jacobbartzen/Alexa_Door_Control/credentials.h

#pragma once

#define WIFI_SSID       "WIFI_SSID"
#define WIFI_PASS       "WIFI_PASS"

#define SINRIC_APP_KEY      "GLOBAL_APP_KEY"       // From Sinric Pro dashboard
#define SINRIC_APP_SECRET   "GLOBAL_APP_SECRET"    // From Sinric Pro dashboard
#define SINRIC_DEVICE_ID    "DEVICE_SPECIFIC_ID"     // From Sinric Pro dashboard
