jacobbartzen/Alexa_Door_Control/(commit log)

2026-04-30 Add README for Alexa-Compatible Door Control project
    Add detailed project overview, design decisions, features, limitations, safety procedures, assembly instructions, and future improvements for Alexa-compatible bedroom door control.
2026-05-01 Enhance README with details on printed parts and assembly
    Updated the printed parts section to include information on verifying tolerances and downloading files from Onshape.
